IoTVision/HardwareLibrary/ModuleHardware/4-20mAConverter.kicad_sch

## KiCad design ModuleHardware/4-20mAConverter.kicad_sch (2023-04-07)

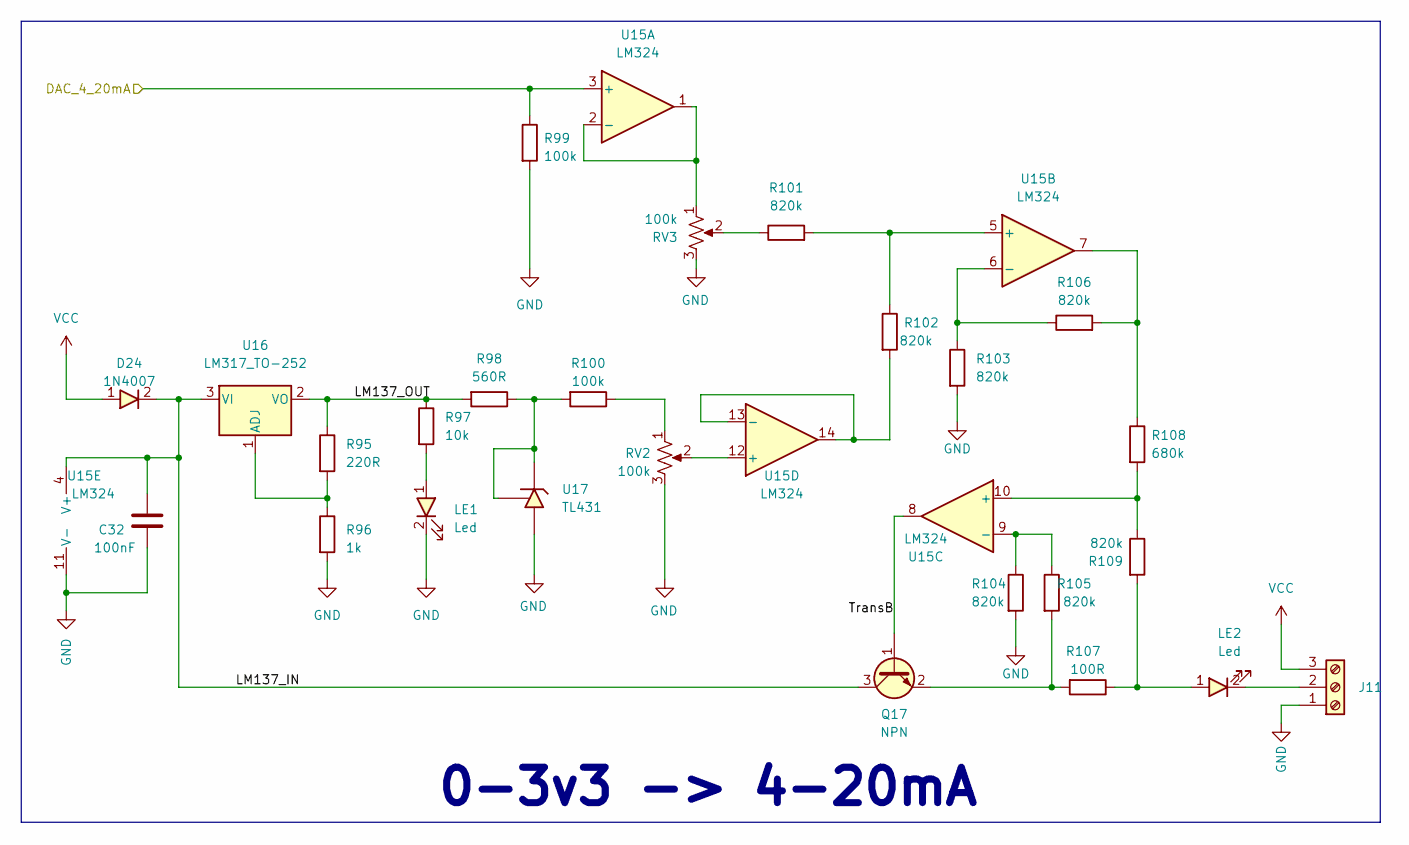
[picture p1: schematic 4-20mAConverter.kicad_sch]

Parts:
C32: 100nF; C0603
D24: 1N4007; D_SMA
J11: HT3.96mm-3P; Terminal_HT-P3.96mm-3P-Vertical-Pluggable
LE1: Led; LED0603
LE2: Led; LED0805
Q17: NPN; SOT23-3
R95: 220R; R0603
R96: 1k; R0603
R97: 10k; R0603
R98: 560R; R0603
R99, R100: 100k; R0603
R101, R102, R103, R104, R105, R106, R109: 820k; R0603
R107: 100R; R0603
R108: 680k; R0603
RV2, RV3: 100k; Potentiometer_Bourns_TC33X_Vertical
U15: LM324; SOIC14
U16: LM317_TO-252; TO-252-2
U17: TL431; SOT23-3

Connections:
DAC_4_20mA: R99.1, U15.3 (+)
GND: C32.2, J11.1, LE1.2, R96.2, R99.2, R103.2, R104.2, RV2.3, RV3.3, U15.11 (V-), U17.3 (A)
LM137_IN: C32.1, D24.2, Q17.3 (C), U15.4 (V+), U16.3 (VI)
LM137_OUT: R95.1, R97.1, R98.2, U16.2 (VO)
unnamed: J11.2, LE2.2
unnamed: LE1.1, R97.2
unnamed: LE2.1, R107.1, R109.2
unnamed: Q17.2 (E), R105.2, R107.2
unnamed: R95.2, R96.1, U16.1 (ADJ)
unnamed: R100.1, RV2.1
unnamed: R98.1, R100.2, U17.1 (K), U17.2 (REF)
unnamed: R101.1, RV3.2
unnamed: R101.2, R102.1, U15.5 (+)
unnamed: R102.2, U15.13 (-), U15.14
unnamed: R103.1, R106.1, U15.6 (-)
unnamed: R104.1, R105.1, U15.9 (-)
unnamed: R106.2, R108.1, U15.7
unnamed: R108.2, R109.1, U15.10 (+)
unnamed: RV2.2, U15.12 (+)
unnamed: RV3.1, U15.1, U15.2 (-)
TransB: Q17.1 (B), U15.8
VCC: D24.1, J11.3

Notes on the sheet:
0-3v3 -> 4-20mA
