IoTVision/HardwareLibrary/ModuleHardware/EEPROM_24LC256.kicad_sch

## KiCad design ModuleHardware/EEPROM_24LC256.kicad_sch (2023-04-07)

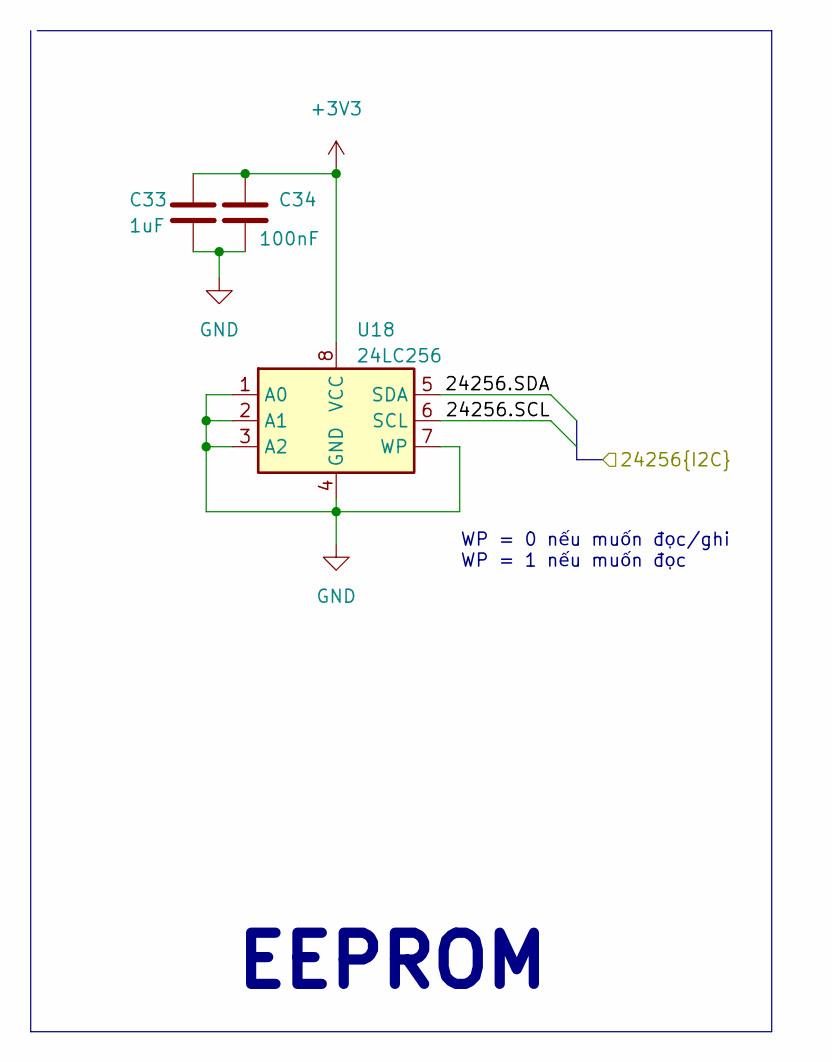
[picture p2: schematic EEPROM_24LC256.kicad_sch]

Parts:
C33: 1uF; C0603
C34: 100nF; C0603
U18: 24LC256; SOIC-8_3.9x4.9mm_P1.27mm

Connections:
24256.SCL: U18.6 (SCL)
24256.SDA: U18.5 (SDA)
+3V3: C33.1, C34.1, U18.8 (VCC)
GND: C33.2, C34.2, U18.1 (A0), U18.2 (A1), U18.3 (A2), U18.4 (GND), U18.7 (WP)

Notes on the sheet:
EEPROM
WP = 0 nếu muốn đọc/ghi WP = 1 nếu muốn đọc
