IoTVision/HardwareLibrary/ModuleHardware/ESP32-WROOM-32E.kicad_sch

## KiCad design ModuleHardware/ESP32-WROOM-32E.kicad_sch (2023-04-07)

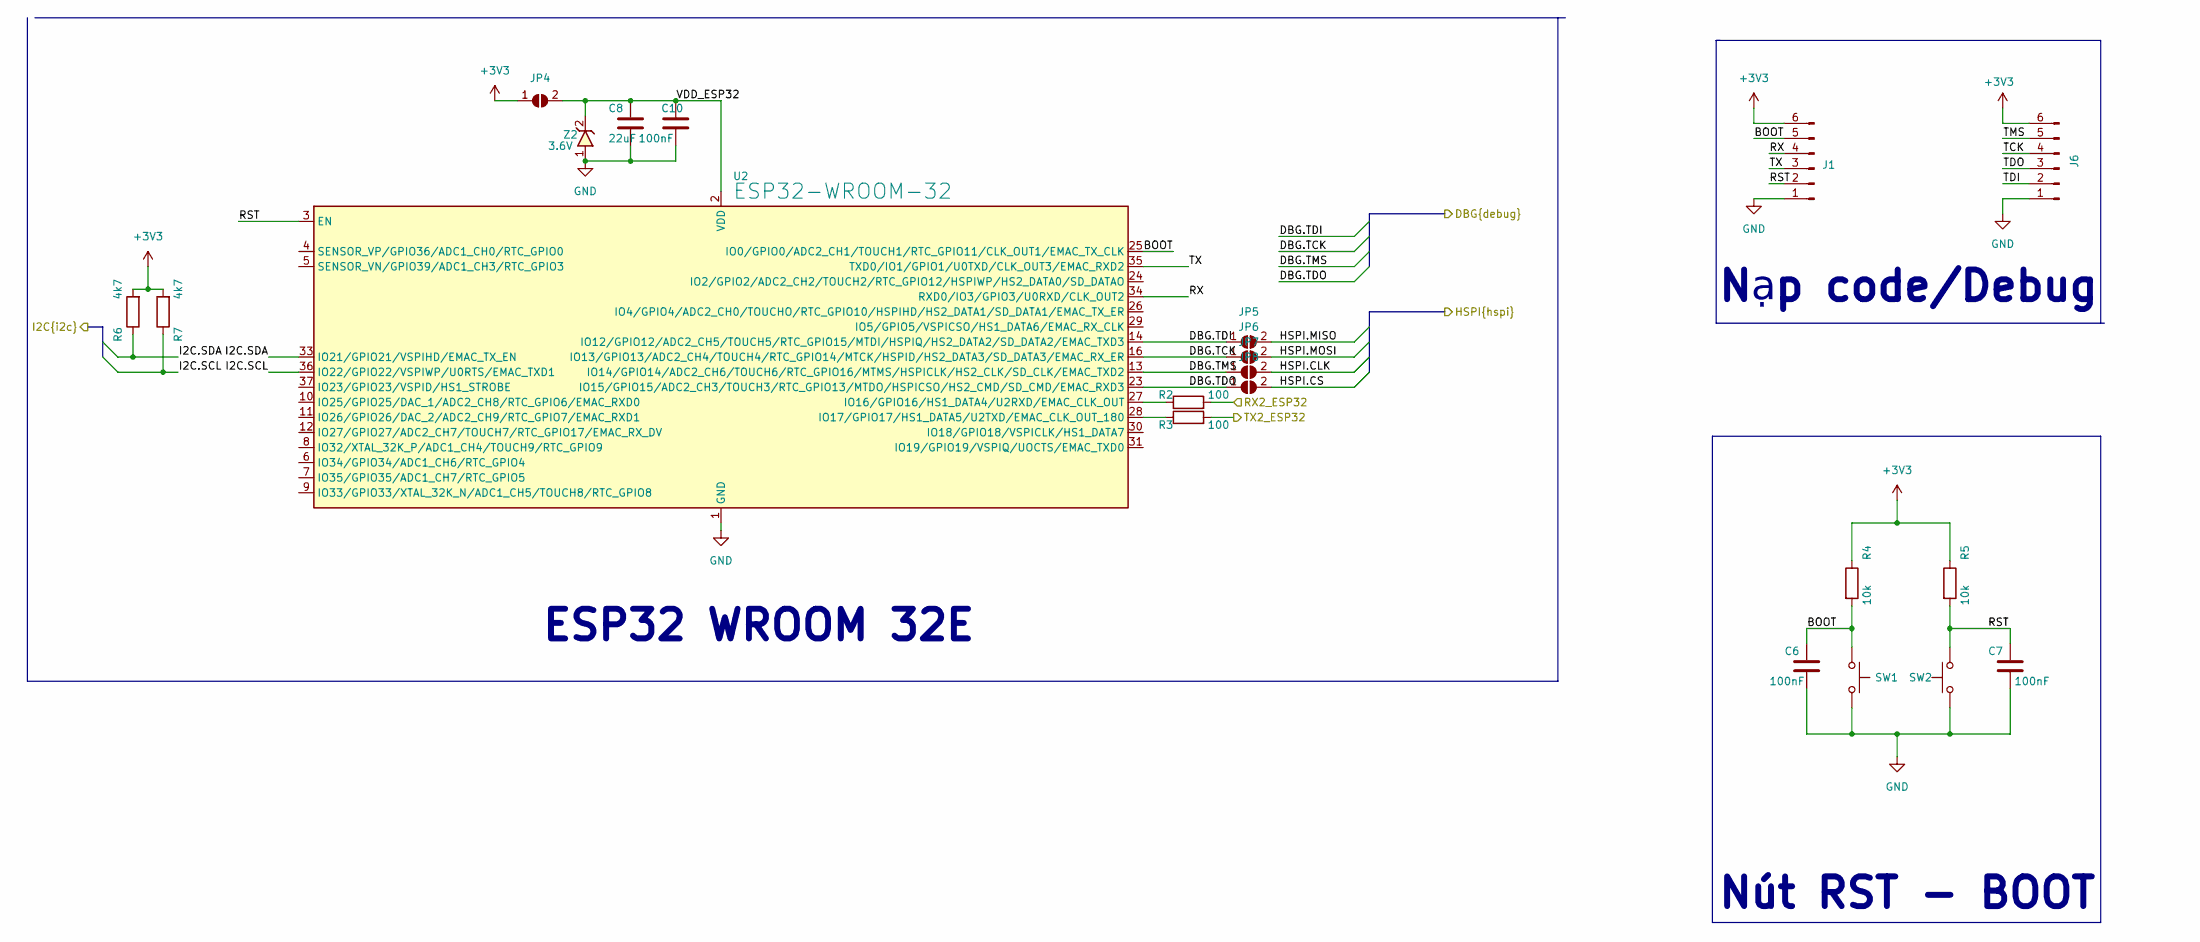
[picture p3: schematic ESP32-WROOM-32E.kicad_sch]

Parts:
C6, C7, C10: 100nF; C0603
C8: 22uF; C0603
J1, J6: Conn_01x05_Male; PinHeader_1x06_P2.54mm_Vertical
JP4: SolderJumper-2_P1.3mm_Open_RoundedPad1.0x1.5mm
JP5, JP6, JP7, JP8: SolderJumper_2_Open
R2, R3: 100; R0603
R4, R5: 10k; R0603
R6, R7: 4k7; R0603
SW1, SW2: SW_Push; SW_SPST_PTS810
U2: ESP32-WROOM-32
Z2: 3.6V; D_MiniMELF

Connections:
+3V3: J1.6, J6.6, JP4.1 (A), R4.1, R5.1, R6.2, R7.2
BOOT: C6.1, J1.5, R4.2, SW1.1, U2.25 (IO0/GPIO0/ADC2_CH1/TOUCH1/RTC_GPIO11/CL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)
DBG.TCK: JP6.1 (A), U2.16 (IO13/GPIO13/ADC2_CH4/TOUCH4/RTC_GPIO14/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)
DBG.TDI: JP5.1 (A), U2.14 (IO12/GPIO12/ADC2_CH5/TOUCH5/RTC_GPIO15/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)
DBG.TDO: JP8.1 (A), U2.23 (IO15/GPIO15/ADC2_CH3/TOUCH3/RTC_GPIO13/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)
DBG.TMS: JP7.1 (A), U2.13 (IO14/GPIO14/ADC2_CH6/TOUCH6/RTC_GPIO16/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)
GND: C6.2, C7.2, C8.2, C10.2, J1.1, J6.1, SW1.2, SW2.1, U2.1 (GND), U2.15 (GND), U2.38 (GND), U2.39 (GND), Z2.1
HSPI.CLK: JP7.2 (B)
HSPI.CS: JP8.2 (B)
HSPI.MISO: JP5.2 (B)
HSPI.MOSI: JP6.2 (B)
I2C.SCL: R7.1, U2.36 (IO22/GPIO22/VSPIWP/U0RTS/EMAC_TXD1)
I2C.SDA: R6.1, U2.33 (IO21/GPIO21/VSPIHD/EMAC_TX_EN)
unnamed: R2.1, U2.27 (IO16/GPIO16/HS1_DATA4/U2RXD/EMAC_CLK_OUT)
unnamed: R3.1, U2.28 (IO17/GPIO17/HS1_DATA5/U2TXD/EMAC_CLK_OU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)
RST: C7.1, J1.2, R5.2, SW2.2, U2.3 (EN)
RX: J1.4, U2.34 (RXD0/IO3/GPIO3/U0RXD/CLK_OUT2)
RX2_ESP32: R2.2
TCK: J6.4
TDI: J6.2
TDO: J6.3
TMS: J6.5
TX: J1.3, U2.35 (TXD0/IO1/GPIO1/U0TXD/CLK_OUT3/EMAC_RXD2)
TX2_ESP32: R3.2
VDD_ESP32: C8.1, C10.1, JP4.2 (B), U2.2 (VDD), Z2.2

Notes on the sheet:
ESP32 WROOM 32E
Nạp code/Debug
Nút RST - BOOT
