IoTVision/HardwareLibrary/ModuleHardware/PRESSURE_SENSOR_AMS5915.kicad_sch

## KiCad design ModuleHardware/PRESSURE_SENSOR_AMS5915.kicad_sch (2023-04-07)

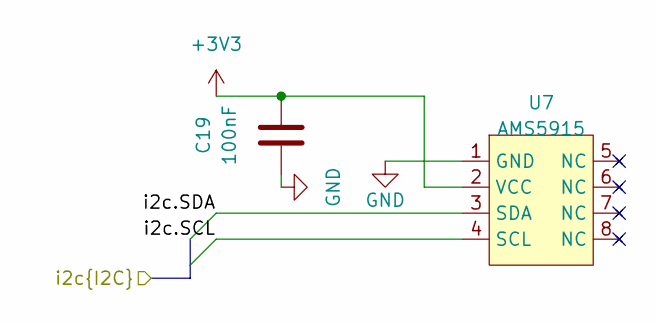
[picture p4: schematic PRESSURE_SENSOR_AMS5915.kicad_sch]

Parts:
C19: 100nF; C0603
U7: AMS5915

Connections:
+3V3: C19.2, U7.2 (VCC)
GND: C19.1, U7.1 (GND)
i2c.SCL: U7.4 (SCL)
i2c.SDA: U7.3 (SDA)
