IoTVision/HardwareLibrary/ModuleHardware/RS485_ISOLATE_MAX485.kicad_sch

## KiCad design ModuleHardware/RS485_ISOLATE_MAX485.kicad_sch (2023-04-11)

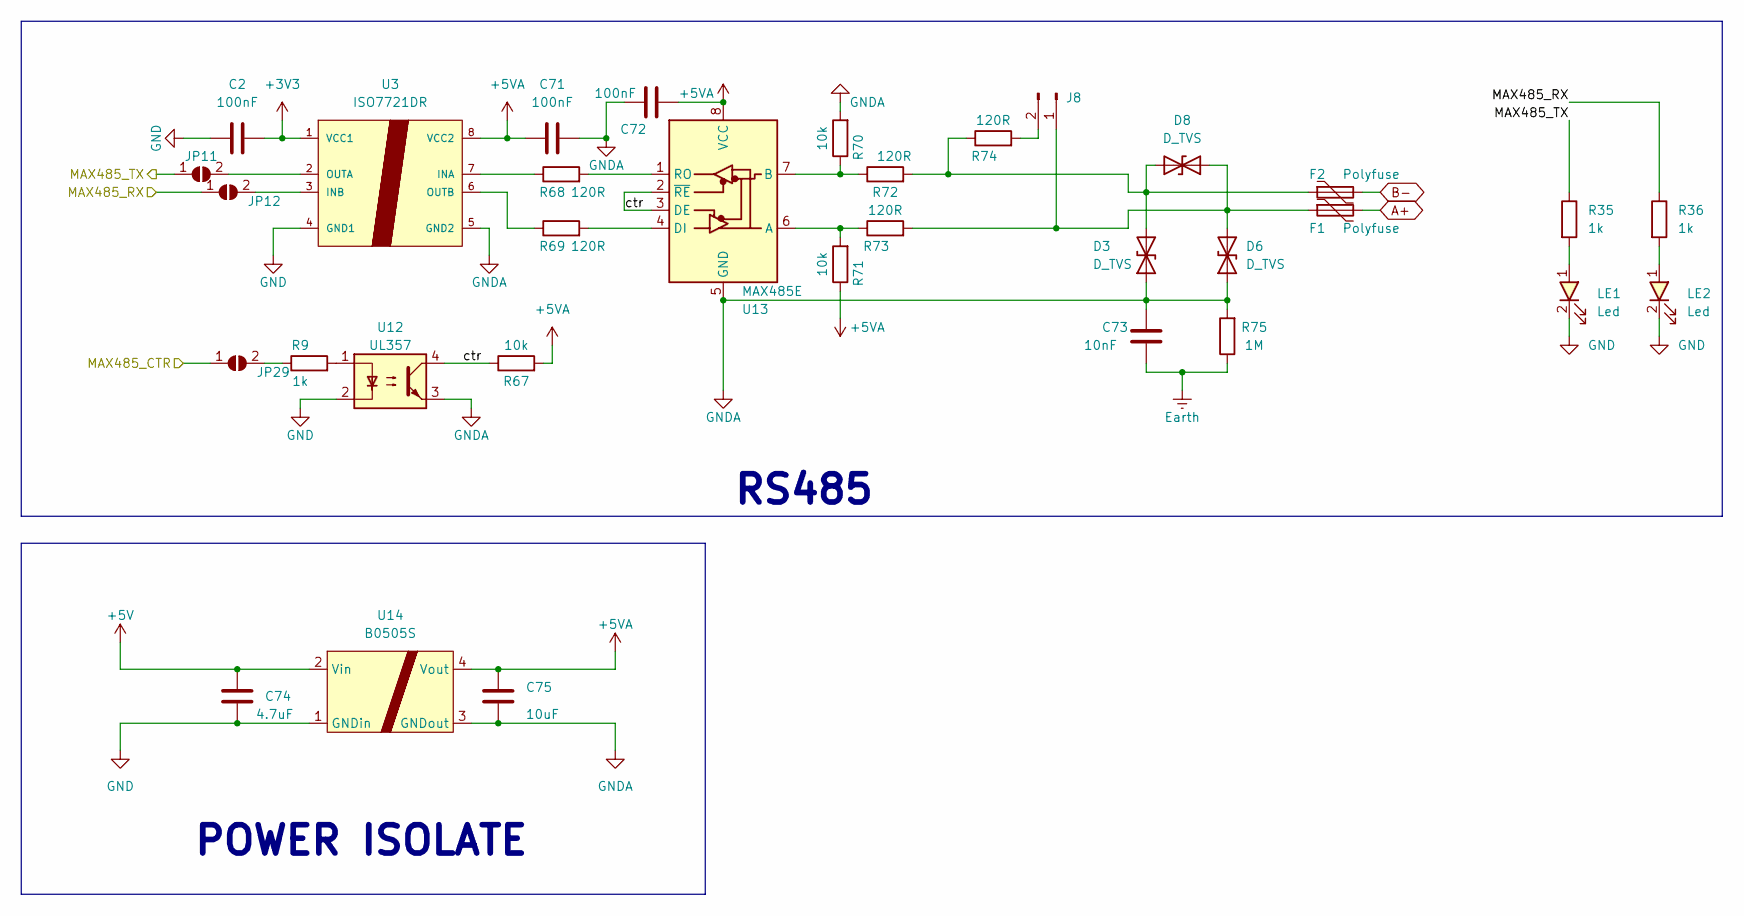
[picture p5: schematic RS485_ISOLATE_MAX485.kicad_sch]

Parts:
C2, C71, C72: 100nF; C0603
C73: 10nF; C0603
C74: 4.7uF; C0603
C75: 10uF; C0603
D3, D6, D8: D_TVS; D_SMA
F1, F2: Polyfuse; Fuse_1812_4532Metric
J8: PinHeader_1x02_P2.54mm_Vertical
JP11, JP12, JP29: SolderJumper-2_P1.3mm_Open_RoundedPad1.0x1.5mm
LE1, LE2: Led; LED0603
R9, R35, R36: 1k; R0603
R67, R70, R71: 10k; R0603
R68, R69, R72, R73, R74: 120R; R0603
R75: 1M; R0603
U3: ISO7721DR; SOIC-8; PARTREV E
U12: UL357; OPTO_EL357N-G
U13: MAX485E; SOIC-8
U14: B0505S; Power_DCDC_Isolate_1W_BxxxxS

Connections:
+3V3: C2.2, U3.1 (VCC1)
+5V: C74.1, U14.2 (Vin)
+5VA: C71.1, C72.2, C75.1, R67.2, R71.1, U3.8 (VCC2), U13.8 (VCC), U14.4 (Vout)
A+: F1.2
B-: F2.2
Earth: C73.1, R75.1
GND: C2.1, C74.2, LE1.2, LE2.2, U3.4 (GND1), U12.2, U14.1 (GNDin)
GNDA: C71.2, C72.1, C73.2, C75.2, D3.1 (A1), D6.1 (A1), R70.2, R75.2, U3.5 (GND2), U12.3, U13.5 (GND), U14.3 (GNDout)
MAX485_CTR: JP29.1 (A)
MAX485_RX: JP12.1 (A), R36.1
MAX485_TX: JP11.1 (A), R35.1
unnamed: D3.2 (A2), D8.2 (A2), F2.1, R72.2, R74.1
unnamed: D6.2 (A2), D8.1 (A1), F1.1, J8.1, R73.2
unnamed: J8.2, R74.2
unnamed: JP11.2 (B), U3.2 (OUTA)
unnamed: JP12.2 (B), U3.3 (INB)
unnamed: JP29.2 (B), R9.1
unnamed: LE1.1, R35.2
unnamed: LE2.1, R36.2
unnamed: R9.2, U12.1
unnamed: R68.1, U3.7 (INA)
unnamed: R68.2, U13.1 (RO)
unnamed: R69.1, U3.6 (OUTB)
unnamed: R69.2, U13.4 (DI)
unnamed: R70.1, R72.1, U13.7 (B)
unnamed: R71.2, R73.1, U13.6 (A)
ctr: R67.1, U12.4, U13.2 (~RE), U13.3 (DE)

Notes on the sheet:
RS485
POWER ISOLATE
