IoTVision/HardwareLibrary/ModuleHardware/STM32F103C8T6.kicad_sch

## KiCad design ModuleHardware/STM32F103C8T6.kicad_sch (2023-04-07)

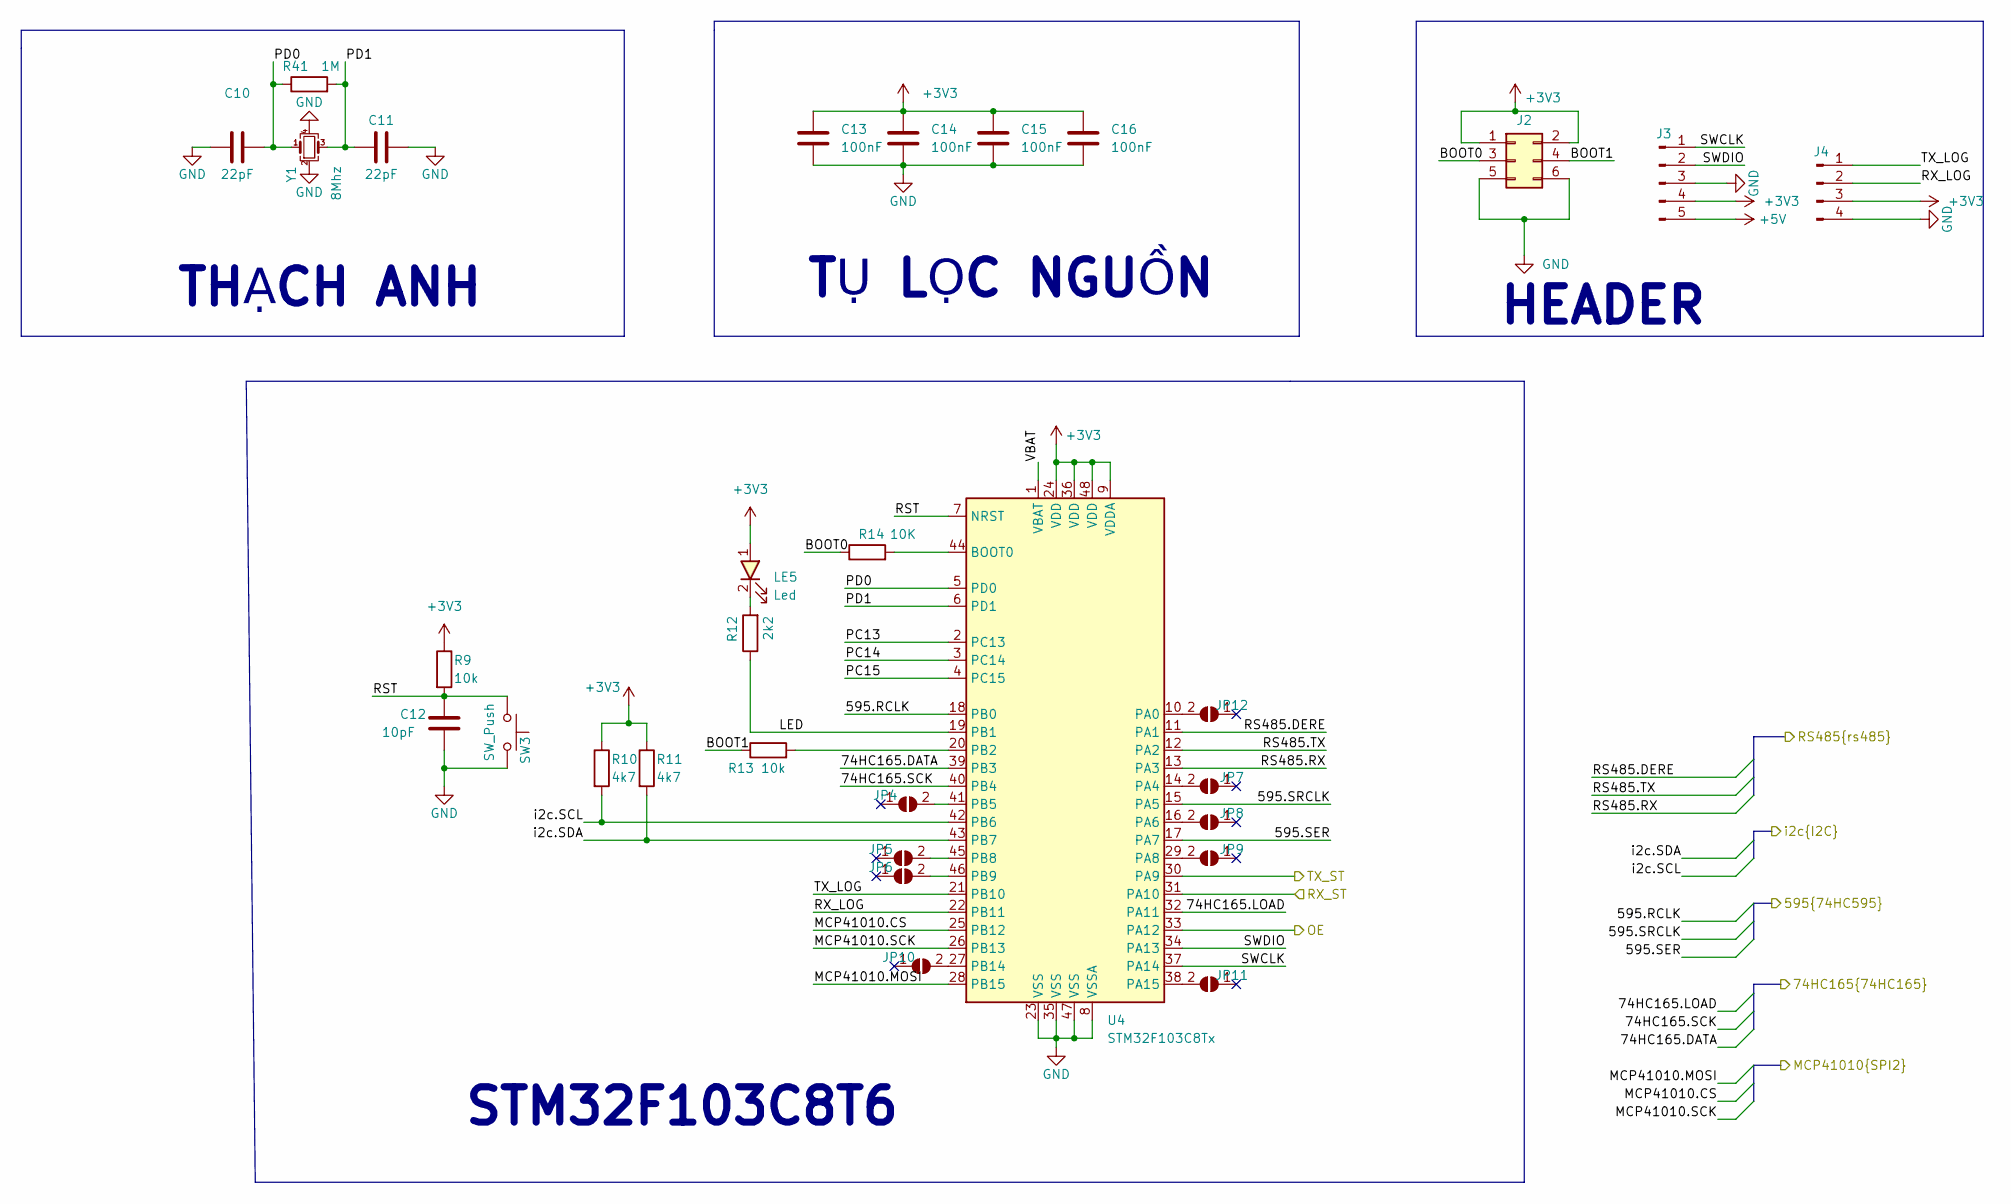
[picture p6: schematic STM32F103C8T6.kicad_sch]

Parts:
C10, C11: 22pF; C0603
C12: 10pF; C0603
C13, C14, C15, C16: 100nF; C0603
J2: Conn_02x03_Odd_Even; PinHeader_2x03_P2.54mm_Vertical
J3: Conn_01x05_Male; PinHeader_1x05_P2.54mm_Vertical
J4: Conn_01x04_Male; PinHeader_1x04_P2.54mm_Vertical
JP4, JP5, JP6, JP7, JP8, JP9, JP10, JP11, JP12: SolderJumper_2_Open; SolderJumper-2_P1.3mm_Open_RoundedPad1.0x1.5mm
LE5: Led; LED0603
R9, R13: 10k; R0603
R10, R11: 4k7; R0603
R12: 2k2; R0603
R14: 10K; R0603
R41: 1M; R0603
SW3: SW_Push; SW_SPST_PTS810
U4: STM32F103C8Tx; LQFP-48_7x7mm_P0.5mm
Y1: 8Mhz; Crystal_SMD_3225-4Pin_3.2x2.5mm

Connections:
74HC165.DATA: U4.39 (PB3)
74HC165.LOAD: U4.32 (PA11)
74HC165.SCK: U4.40 (PB4)
595.RCLK: U4.18 (PB0)
595.SER: U4.17 (PA7)
595.SRCLK: U4.15 (PA5)
+3V3: C13.1, C14.1, C15.1, C16.1, J2.1, J2.2, J3.4, J4.3, LE5.1, R9.1, R10.1, R11.1, U4.9 (VDDA), U4.24 (VDD), U4.36 (VDD), U4.48 (VDD)
+5V: J3.5
BOOT0: J2.3, R14.1
BOOT1: J2.4, R13.1
GND: C10.1, C11.2, C12.1, C13.2, C14.2, C15.2, C16.2, J2.5, J2.6, J3.3, J4.4, SW3.2, U4.8 (VSSA), U4.23 (VSS), U4.35 (VSS), U4.47 (VSS), Y1.2, Y1.4
LED: R12.1, U4.19 (PB1)
MCP41010.CS: U4.25 (PB12)
MCP41010.MOSI: U4.28 (PB15)
MCP41010.SCK: U4.26 (PB13)
unnamed: JP4.2 (B), U4.41 (PB5)
unnamed: JP5.2 (B), U4.45 (PB8)
unnamed: JP6.2 (B), U4.46 (PB9)
unnamed: JP7.2 (B), U4.14 (PA4)
unnamed: JP8.2 (B), U4.16 (PA6)
unnamed: JP9.2 (B), U4.29 (PA8)
unnamed: JP10.2 (B), U4.27 (PB14)
unnamed: JP11.2 (B), U4.38 (PA15)
unnamed: JP12.2 (B), U4.10 (PA0)
unnamed: LE5.2, R12.2
unnamed: R13.2, U4.20 (PB2)
unnamed: R14.2, U4.44 (BOOT0)
OE: U4.33 (PA12)
PC13: U4.2 (PC13)
PC14: U4.3 (PC14)
PC15: U4.4 (PC15)
PD0: C10.2, R41.1, U4.5 (PD0), Y1.1
PD1: C11.1, R41.2, U4.6 (PD1), Y1.3
RS485.DERE: U4.11 (PA1)
RS485.RX: U4.13 (PA3)
RS485.TX: U4.12 (PA2)
RST: C12.2, R9.2, SW3.1, U4.7 (NRST)
RX_LOG: J4.2, U4.22 (PB11)
RX_ST: U4.31 (PA10)
SWCLK: J3.1, U4.37 (PA14)
SWDIO: J3.2, U4.34 (PA13)
TX_LOG: J4.1, U4.21 (PB10)
TX_ST: U4.30 (PA9)
VBAT: U4.1 (VBAT)
i2c.SCL: R10.2, U4.42 (PB6)
i2c.SDA: R11.2, U4.43 (PB7)

Notes on the sheet:
TỤ LỌC NGUỒN
STM32F103C8T6
HEADER
THẠCH ANH
