IoTVision/HardwareLibrary/(threads)

Thread 15 (2023-08-05):

Có bug tại mục connector chứa LED

TM-khoa, 2023-08-05:
