IoTVision/HardwareLibrary/(commit log)

2022-11-28 add Thao's lib and create footprint, symbols RTL8720DN and SIMA7602E-H
2022-11-29 update footprint and symbol SIMa7602e
2022-11-30 change path footprint and symbols
2022-12-01 update links and description for G5NB relay, STF103,DS3231
2022-12-01 Update footprint components
2022-12-05 Change LORA footprint, adding Varistor
2022-12-06 new nano sim socket component, revise SOIC-8
2022-12-10 Create New Footprint, Symbol and modify 3d old footprint
    create:
    new footprint connector pinheader 2.54 2, 4, 7 pin
    new footprint kitDevESP32
    new footprint SOIC8E (expand pad bottom to exothermal - có pad
    dưới chân để giải nhiệt)
    modify:
    change 3d SOIC 8
2022-12-11 mofify 3d and create new footprint
    add female header 2.54 step in devkipESP32 footprint
    create new footprint HY-2.0mm 4pin SMD
2022-12-11 create a new footprint XH 2.54 SMD
2022-12-13 Update footprints
    Add Conn_IPEX_ANT
    Changes name Crystal_3225
    Add D_MiniMELF
    Add D_SOD-128
    Add JST_VH_B2P
    Add Micro_SIM
    Add JST_S2B_XH_SM4_TB
    Add JST_S4B_XH_SM4_TB
2022-12-15 Update Library
    Link IR Receive symbol to footprint and 3D
    Add Barrel Jack DC
    Add TerminalBlock_bornier
2022-12-25 add logo lab in footprint
2022-12-25 Update silkscreen and 3D
2022-12-26 create new footprint SMD diode
2022-12-26 Fix Hole holder of RJ11 6P and 4P
2022-12-29 create new component
    new symbol and footprint Gas Discharge Tubes X5-series, TD301D485
2022-12-29 new component and adjust footprint
    new XH 2.54 3pin and 7pin, symbol and footprint devkitESP32
    modify all XH2.54 and led
2022-12-29 synchronized footprint and symbol diode 1-Anode 2-cathode
2022-12-30 create logo lab, symbol and footprint MPU6050
2023-01-01 modify footprint button 12x12 and devkitESP32, create new connector, led RGB 5050 and logo footprint
2023-01-01 change name R0603, C0603, L0603, led0603, create lora and power connector footprint
2023-01-01 change Pad 5569 to 3mm, pin 1 WS2812, update 3D path
2023-01-05 add LED_Housing
2023-01-07 complete footprint connector DB15 3row
2023-01-13 Fix footprint USB type C (too fit)
2023-01-29 create and modifi foorptint
    create C0402, R0402. R2512 SMD
    radial capacity DIP
    fuse holder BLX A P22.4mm DIP
    buzzer frequency 1.8v DIP
    domino KF128 DIP
    potentiometer WH148-3P DIP
    modified UU9.8 repaint silkscreen
    USB-C longer pad
2023-02-03 change cap elec to alu, fix LED0603
2023-02-09 Update lib
    update 3D B0505S
    change name B0505S to Power_DCDC_Isolate_1W_BxxxxS
    update 3D for button_YD3414
    change DB15 pads & holes smaller than before
2023-02-13 new footprint 7segment 4led cathode 30x14mm, devkitstm32f103, led Dip 5mm
2023-02-16 Change pin 1 to Kathode and pin 2 Anode for diode
2023-02-19 Fix 3D and Footprint for mismatch screw holes
2023-02-21 Add rotary encoder and update LCD
2023-03-09 new footprint IDC 14PIN, D_SOD323, IC TSSOP14
2023-03-11 add selection footprint for symbols diode, schotky, zener
2023-03-13 add symbol and footprint AM22-22W2405V
2023-03-13 add HT-3,96mm and KF-5.08mm
2023-03-13 add footprint AMS5915
2023-03-14 newfootprint LED0805, SOIC14, SOT223
2023-03-15 fix footprint AMS5915 and AM22W2405V
2023-03-15 fix name some footprints
2023-03-16 change pin LED0805
2023-04-05 Add ESP32_WROOM_32 to lib
2023-04-07 Add ModuleHardware library
    [4-20mAConverter.kicad_sch, EEPROM_24LC256.kicad_sch, ESP32-WROOM-32E.kicad_sch, PRESSURE_SENSOR_AMS5915.kicad_sch, STM32F103C8T6.kicad_sch]
2023-04-07 Add TSSOP-16
    [RS485_ISOLATE_MAX485.kicad_sch]
2023-04-10 Edit symbol of MCU STM32F103 package 48 pin
2023-04-11 add esp32-c3-12f and esp07 footprint and symbol
2023-04-12 synchronized footprint' lab and Mai Van Anh' lib
2023-04-13 modify batteryHold, Crystal, D_SMA, Led, SOIC16, SOT23, SWITCH
2023-07-10 update multiple footprints, 3D links and add new components
2023-07-16 add fp buz_12x6_pitch6.6mm
2023-07-25 Rename multiple footprint
2023-07-28 Rename multiple footprints 2
2023-08-02 update README in footprint
2023-08-11 update: 3D, add multiple footprints
